Bittersweet2701/Autonomous-Vehicle/README.md

# Graduation_Thesis
# Autonomous-Vehicle
