Bittersweet2701/Autonomous-Vehicle/Hardware/AutonomousVehicle_CurrentMeasurement/AutonomousVehicle_CurrentMeasure.pdf

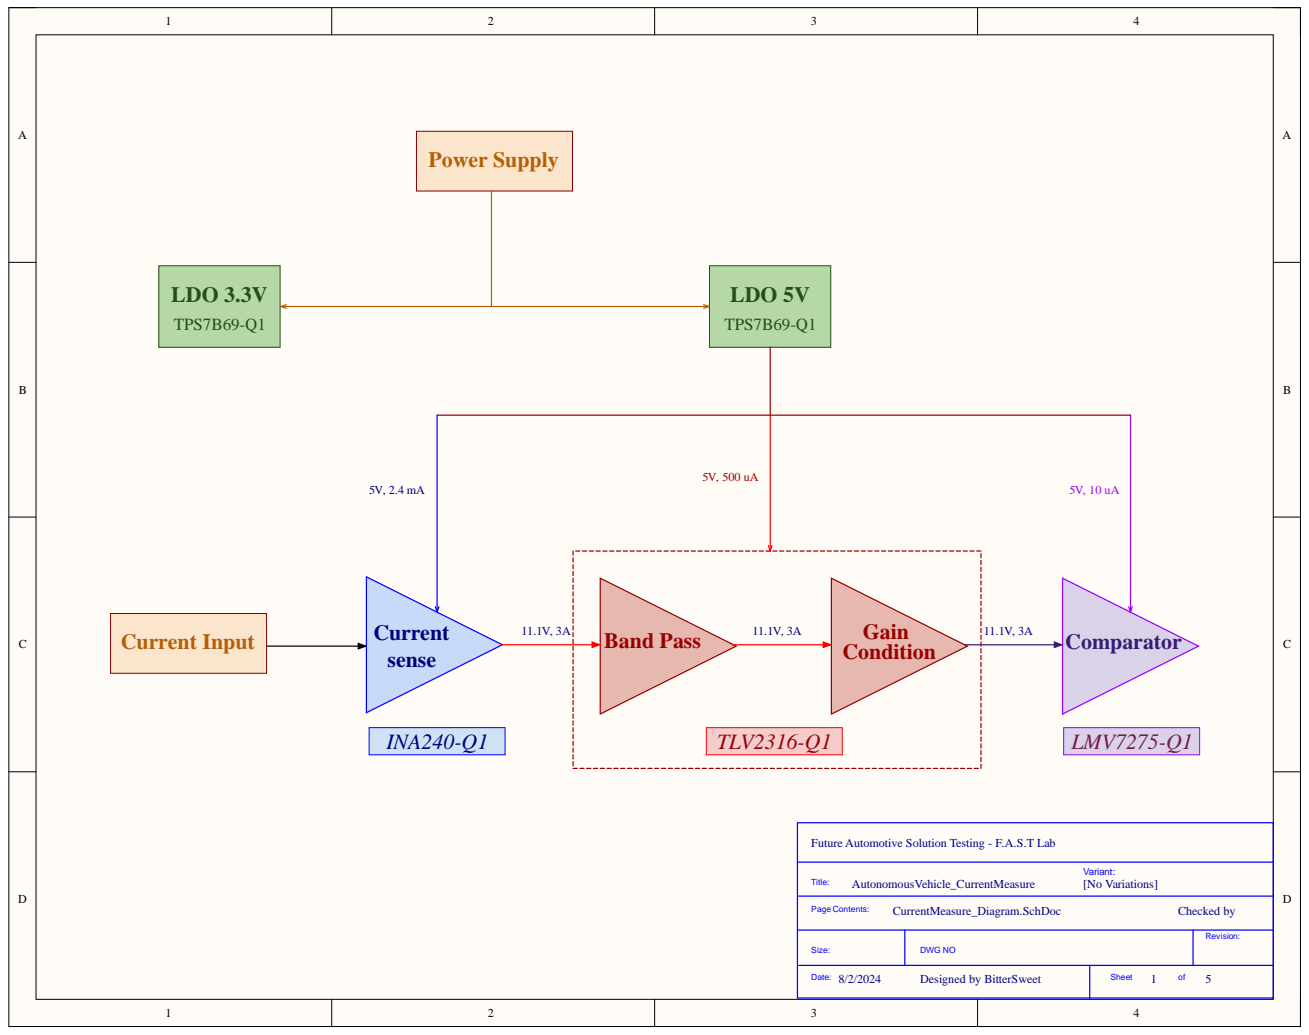
[picture p3: page 1]

Future Automotive Solution Testing - F.A.S.T Lab

Size: | DWG NO | Revision:

Date: 8/2/2024 Designed by BitterSweet | Sheet of

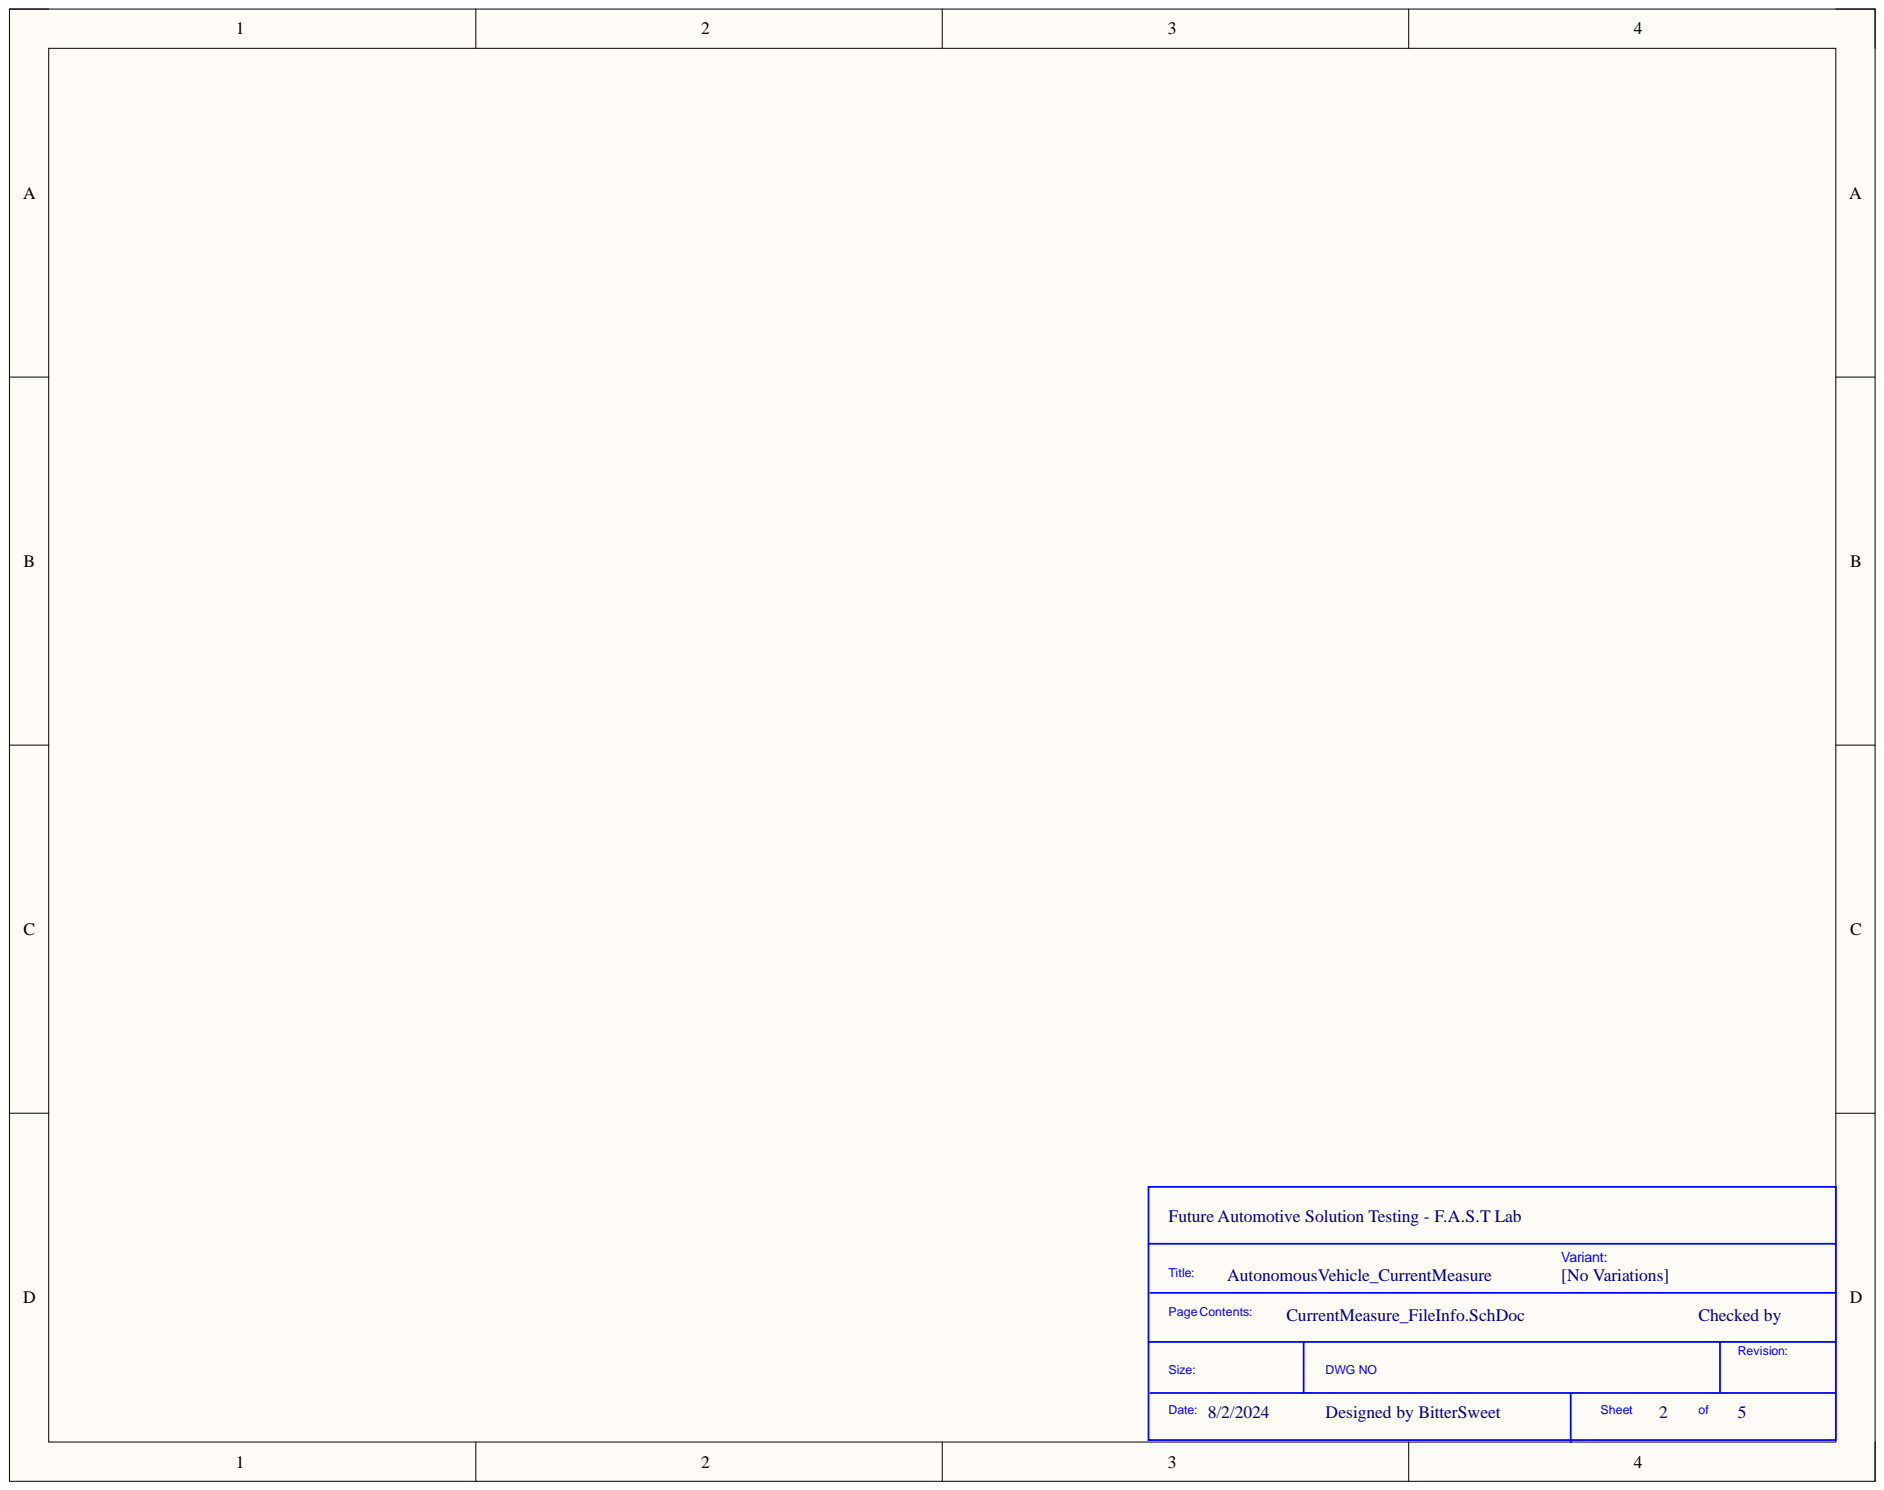
[picture p4: page 2]

Future Automotive Solution Testing - F.A.S.T Lab

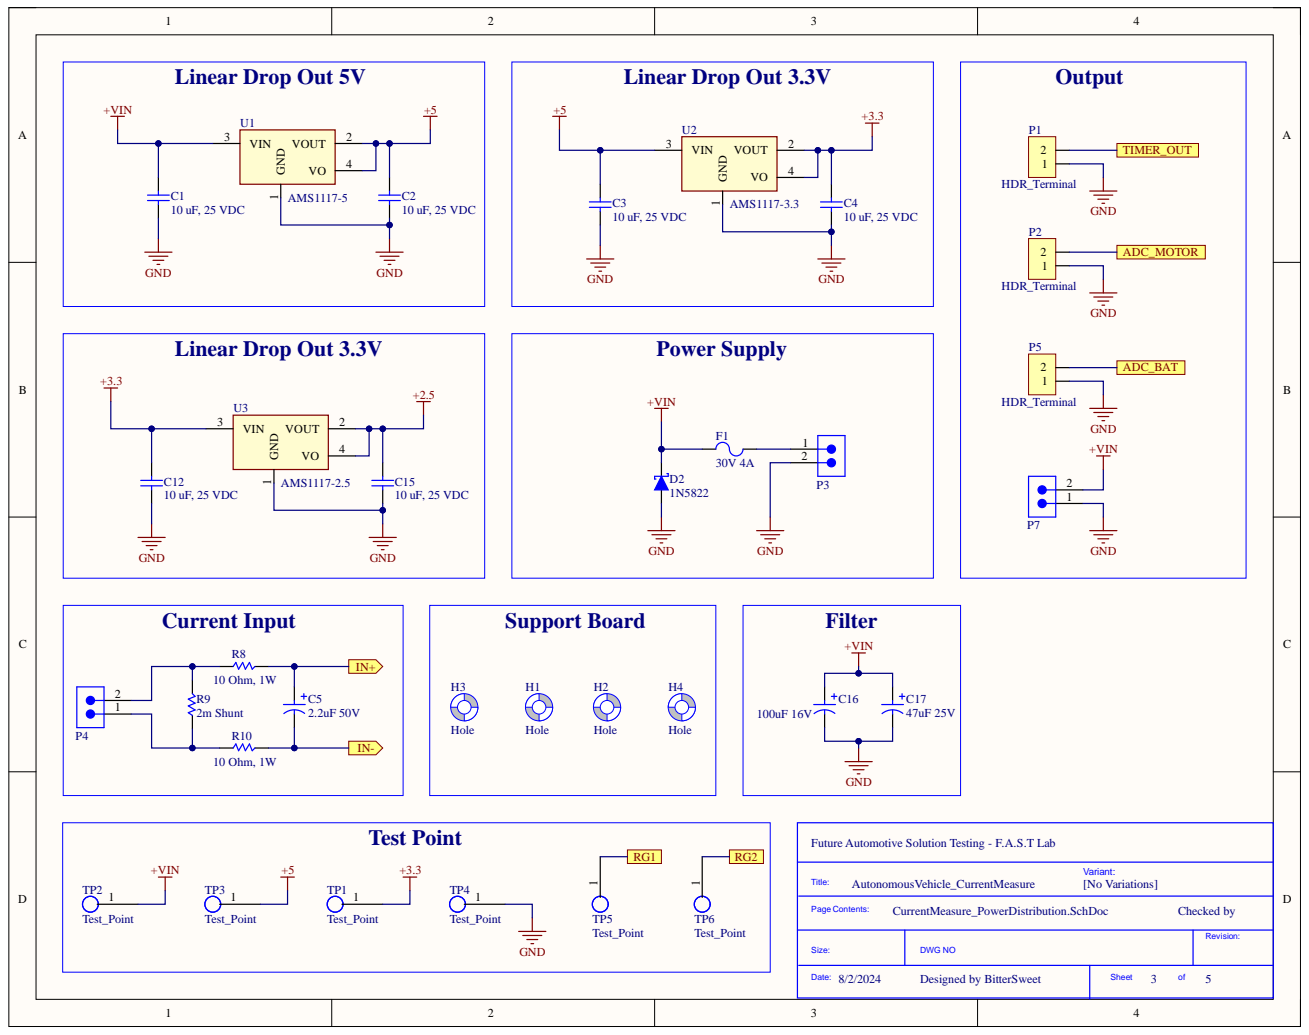
[picture p5: page 3]

Future Automotive Solution Testing - F.A.S.T Lab

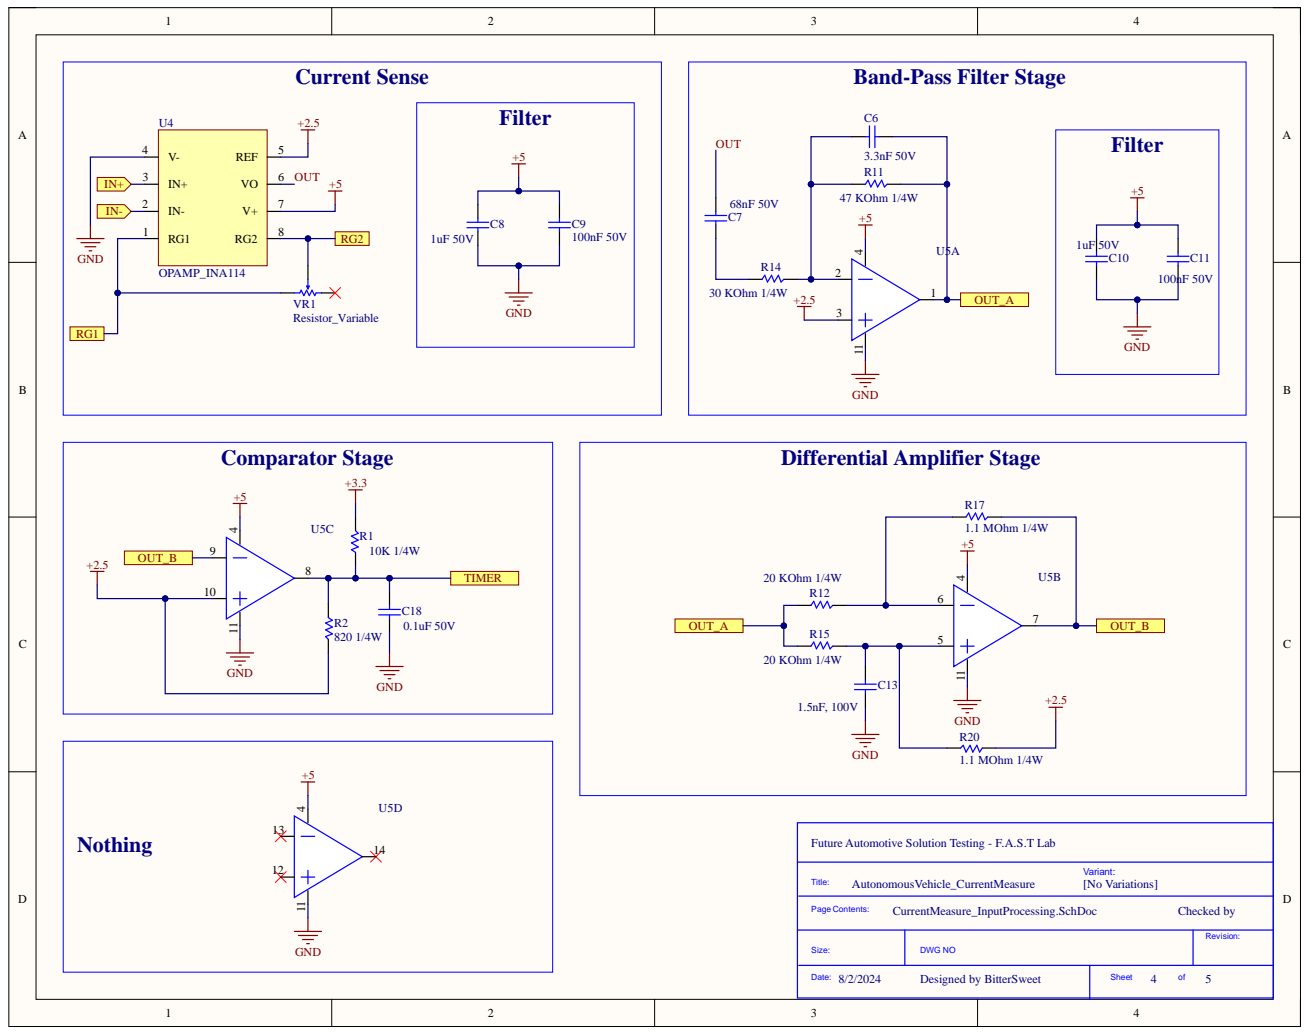
[picture p6: page 4]

Band-Pass Filter Stage

Future Automotive Solution Testing - F.A.S.T Lab

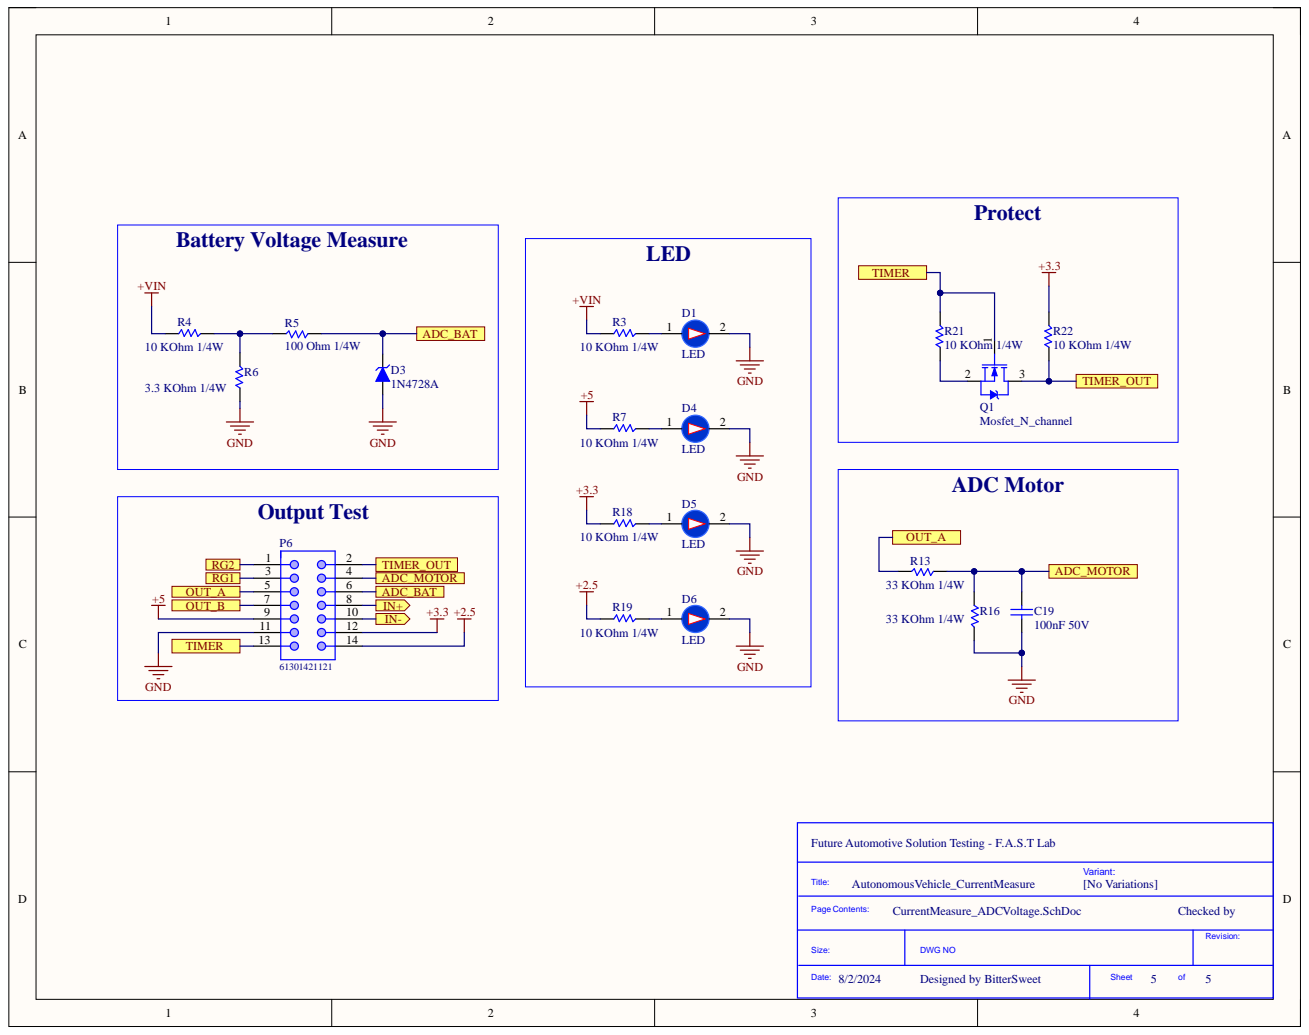
[picture p7: page 5]

Date : 8/2/2024 D e s igned by Bi t t erS w e e t | Sh e e t o f
