Bittersweet2701/Autonomous-Vehicle/Hardware/AutonomousVehicle_MotherBoard/MotherBoard_Diagram.pdf

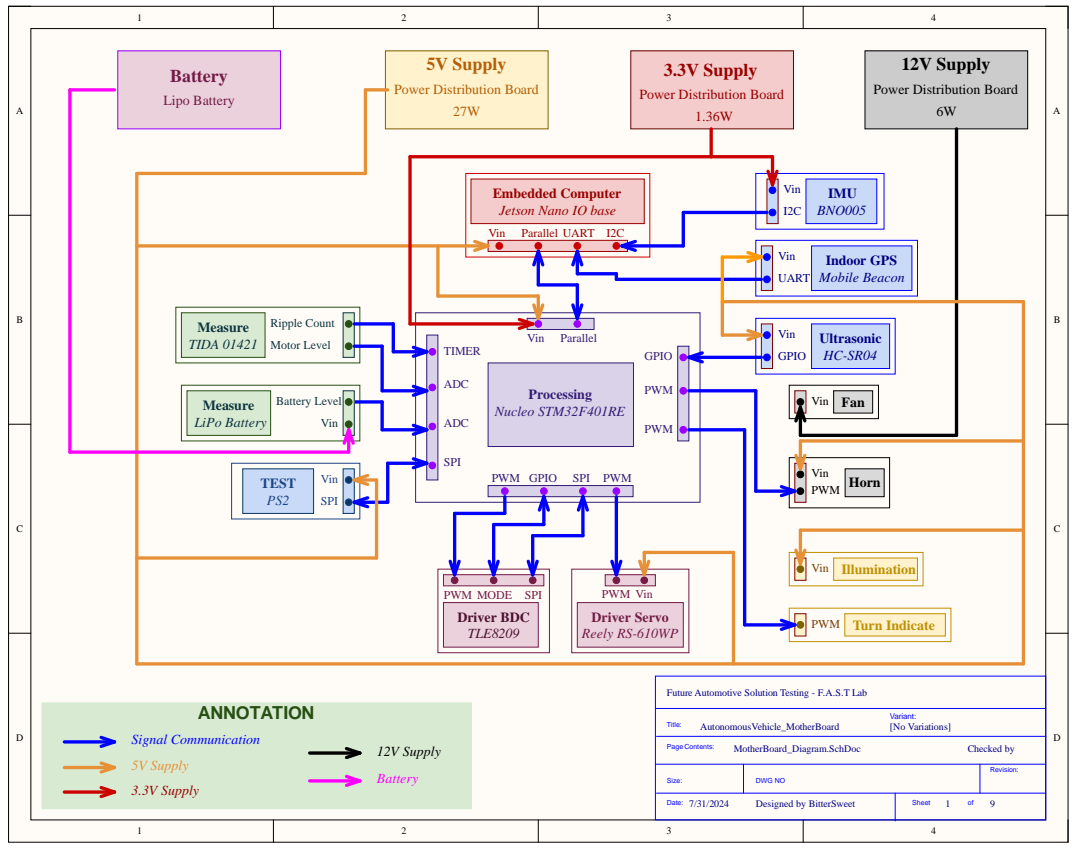
[picture p8: page 1]

Embedded Computer
Jetson Nano IO base

Future Automotive Solution Testing - F.A.S.T Lab

Size: | DWG NO | Revision:

Date: 7/31/2024 Designed by BitterSweet | Sheet 1 of 9
