Bittersweet2701/Autonomous-Vehicle/Hardware/Autonomous_Vehicle_PowerBoard/Autonomous/AutonomousVehicle_PowerBoard.pdf

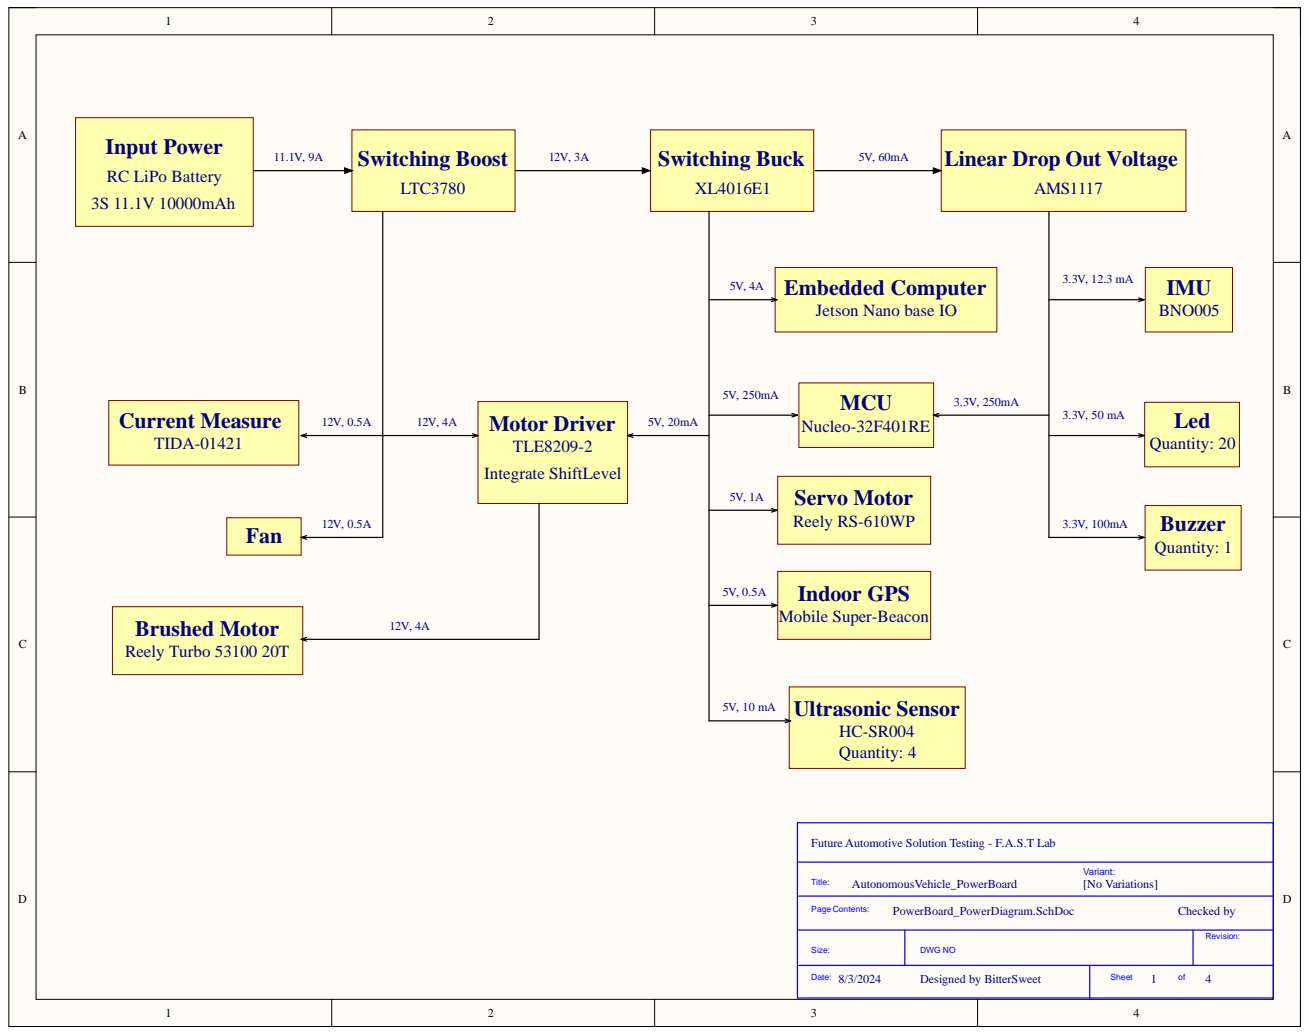
[picture p14: page 1]

Linear Drop Out Voltage

Embedded Computer
Jetson Nano base IO

Future Automotive Solution Testing - F.A.S.T Lab

Size: | DWG NO | Revision:

Date: 8/3/2024 Designed by BitterSweet | Sheet of

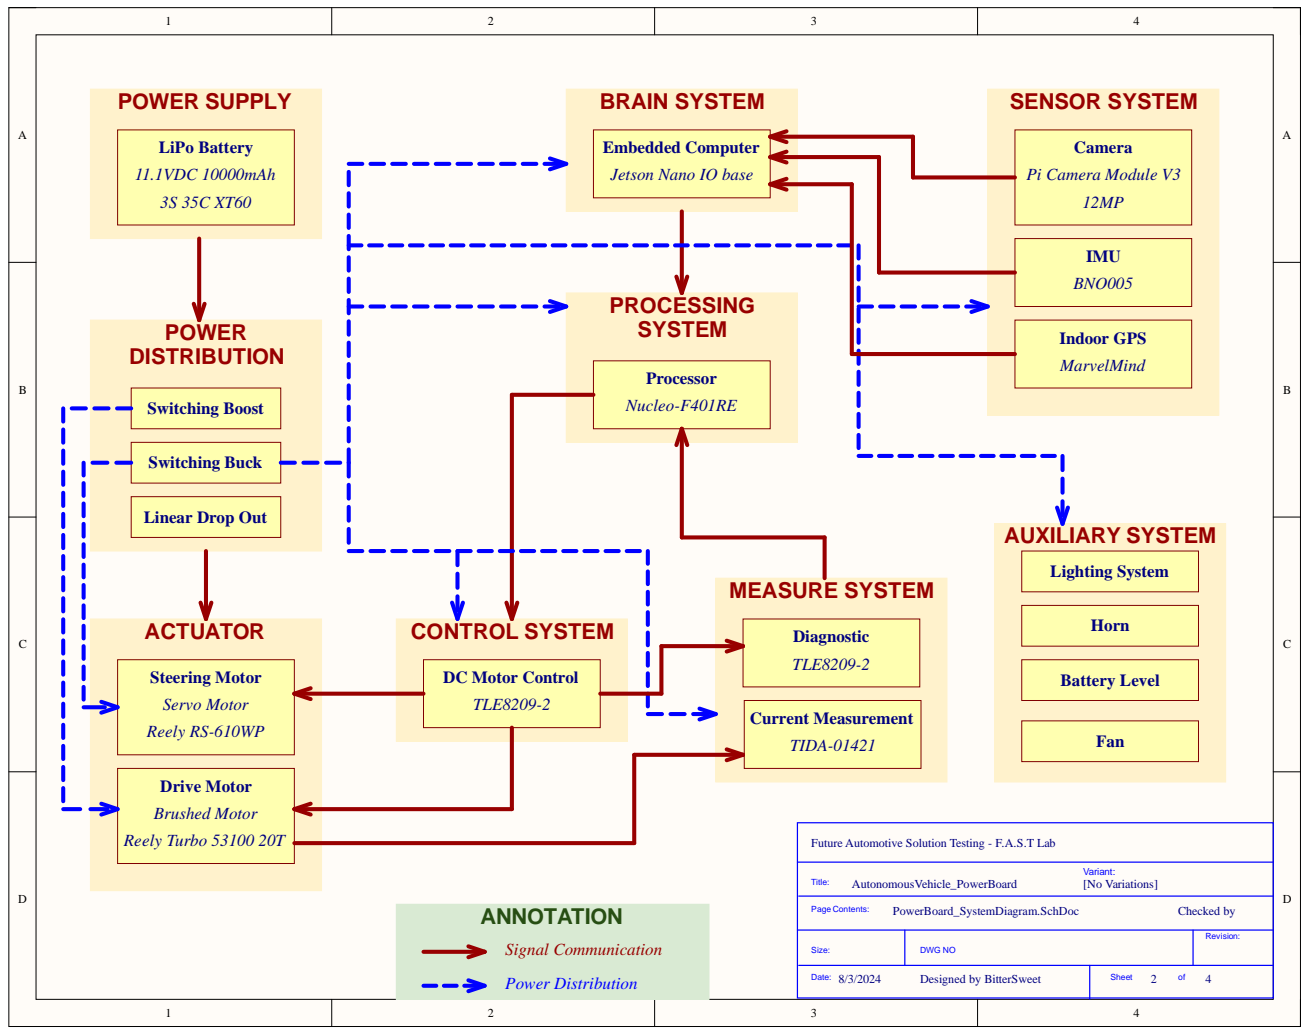
[picture p15: page 2]

Embedded Computer
Jetson Nano IO base

Future Automotive Solution Testing - F.A.S.T Lab

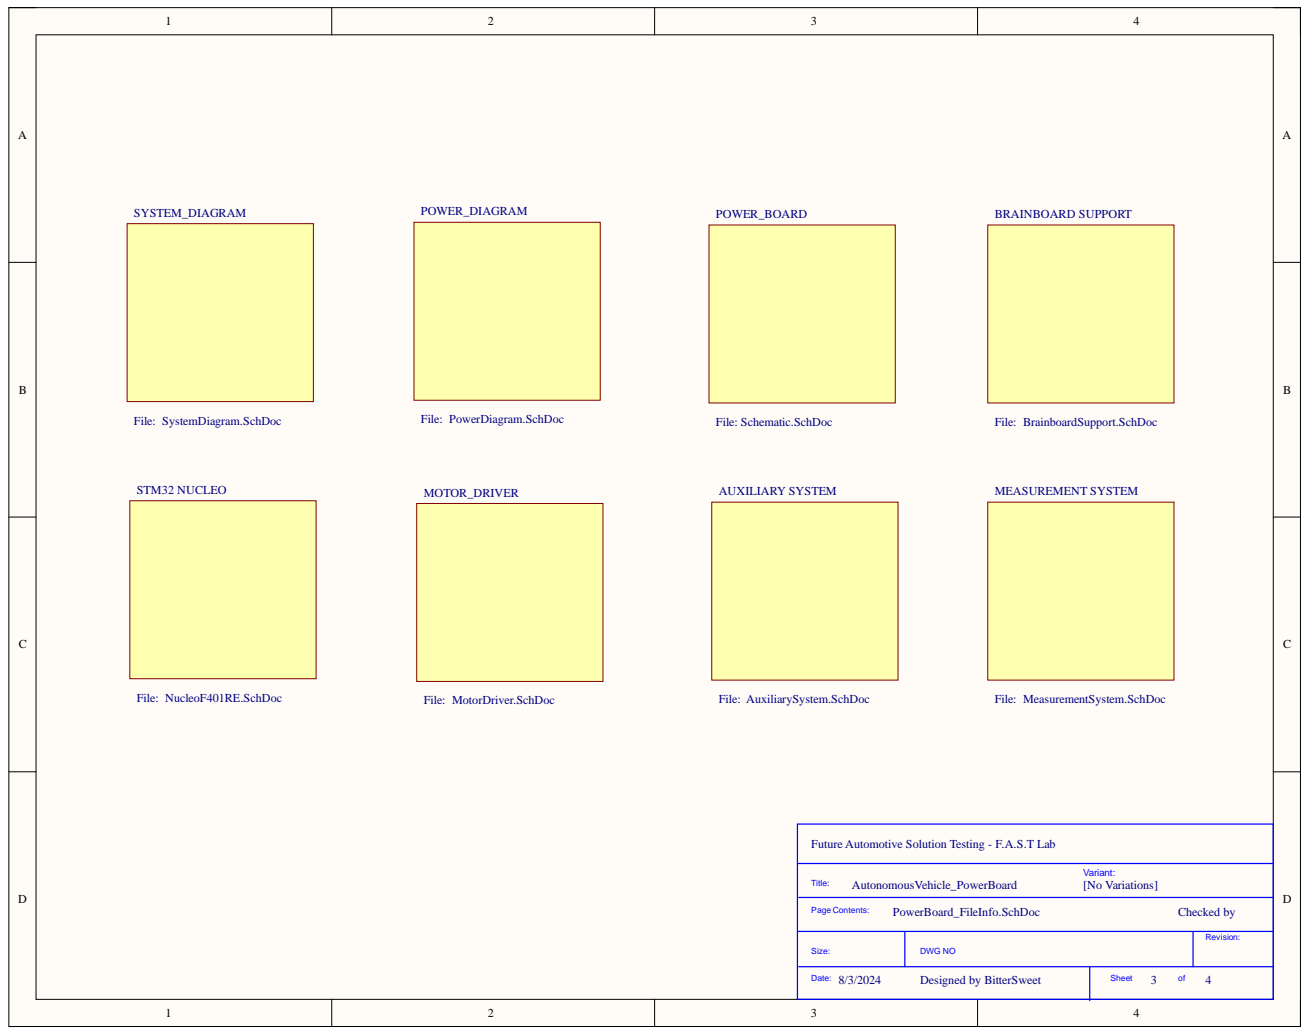
[picture p16: page 3]

Future Automotive Solution Testing - F.A.S.T Lab

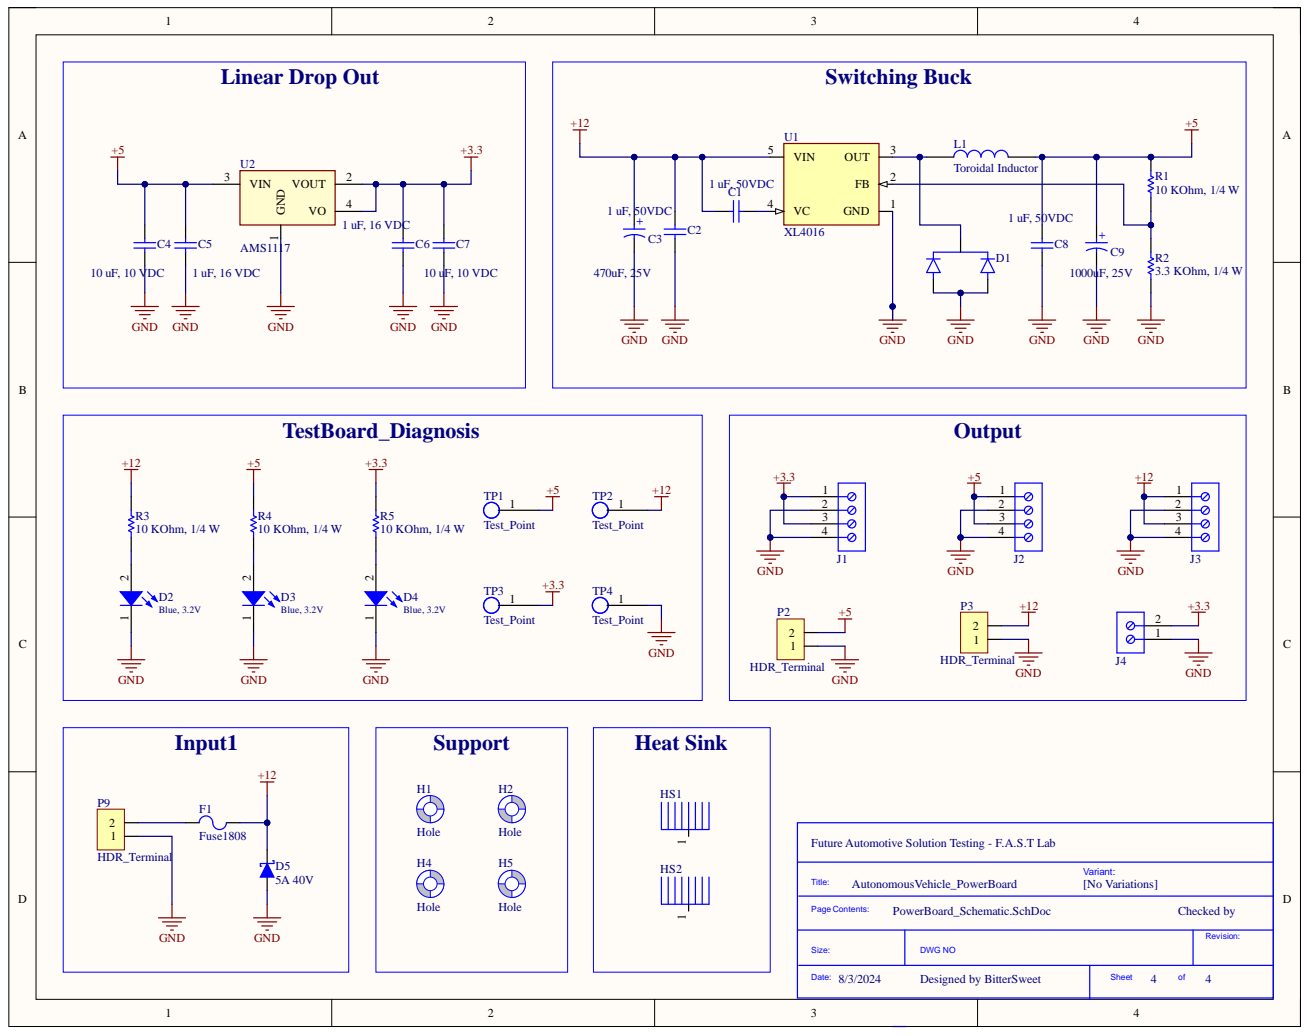
[picture p17: page 4]

Future Automotive Solution Testing - F.A.S.T Lab

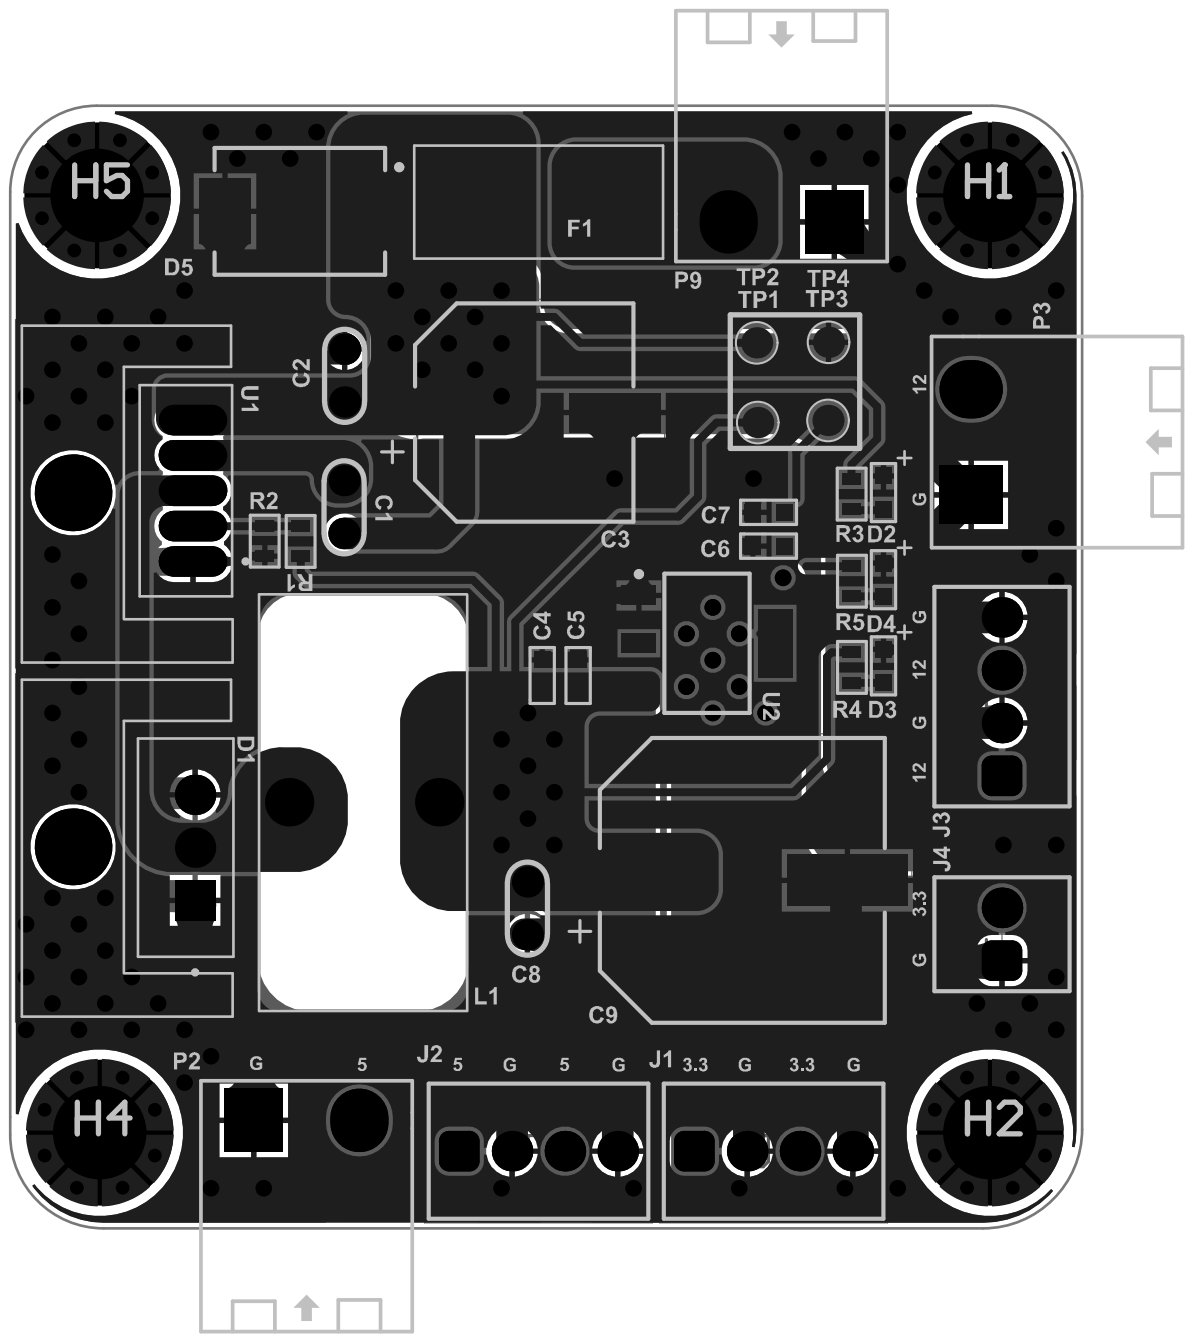
[picture p18: page 5]
