Bittersweet2701/Autonomous-Vehicle/Hardware/AutonomousVehicle_MotherBoard/AutonomousVehicle_MotherBoard.pdf

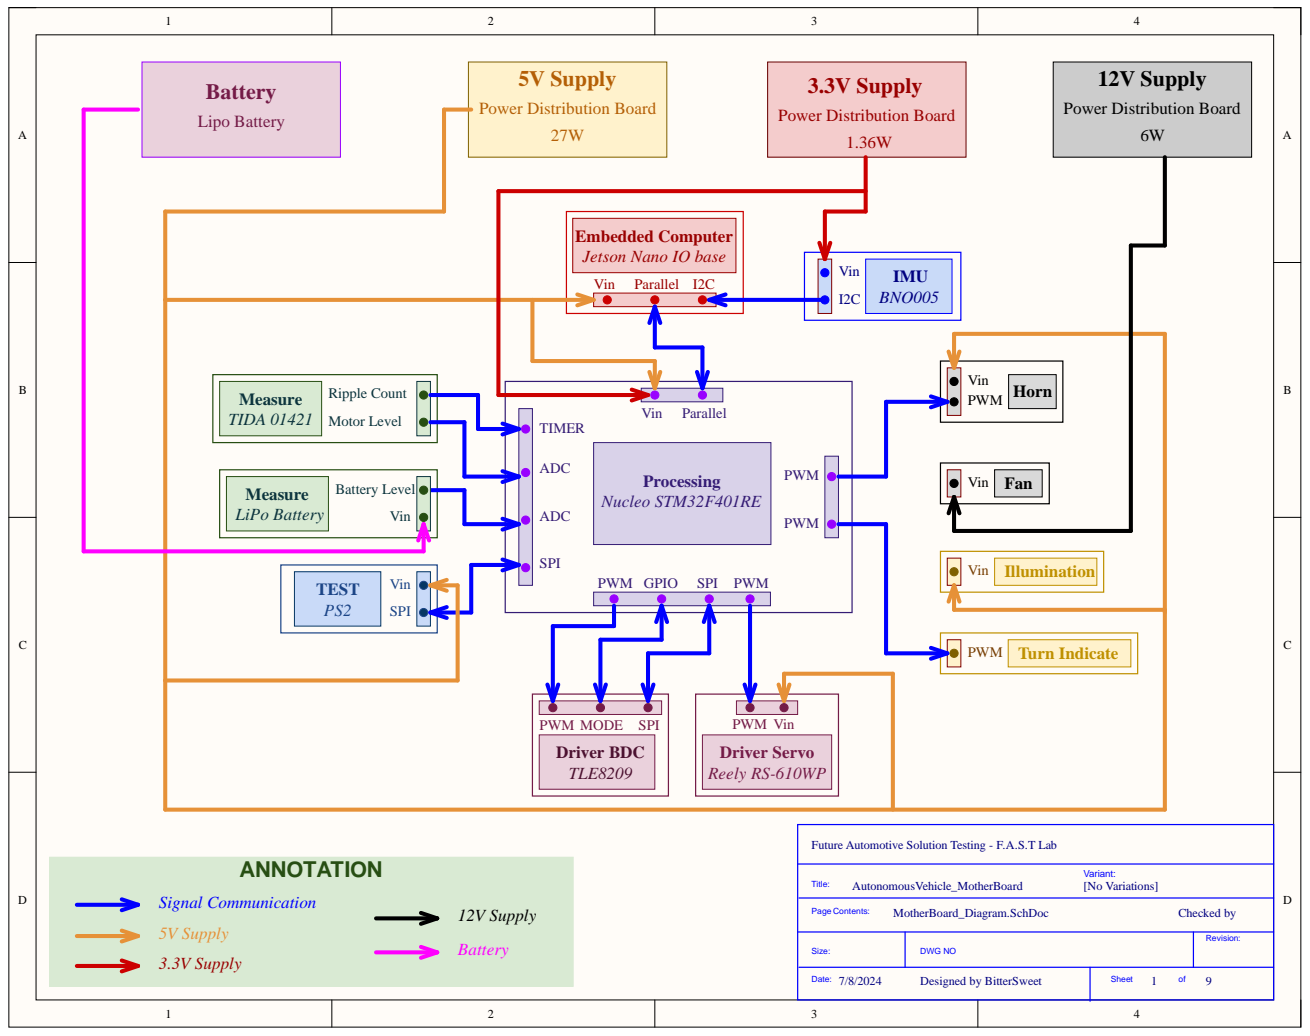
[picture p19: page 1]

Embedded Computer
Jetson Nano IO base

Future Automotive Solution Testing - F.A.S.T Lab

Size: | DWG NO | Revision:

Date: 7/8/2024 Designed by BitterSweet | Sheet of

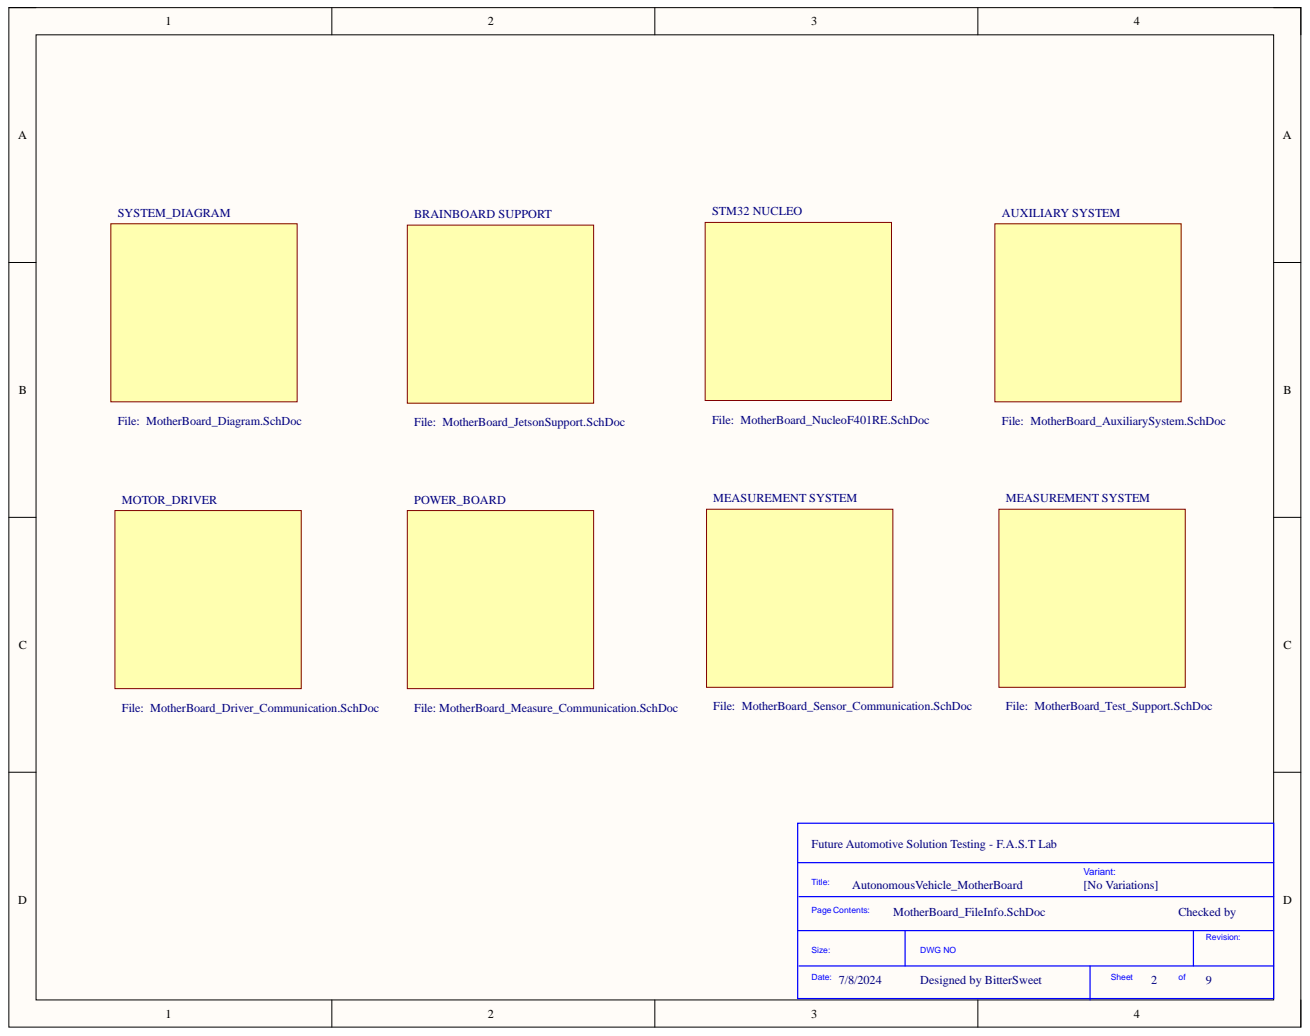
[picture p20: page 2]

Future Automotive Solution Testing - F.A.S.T Lab

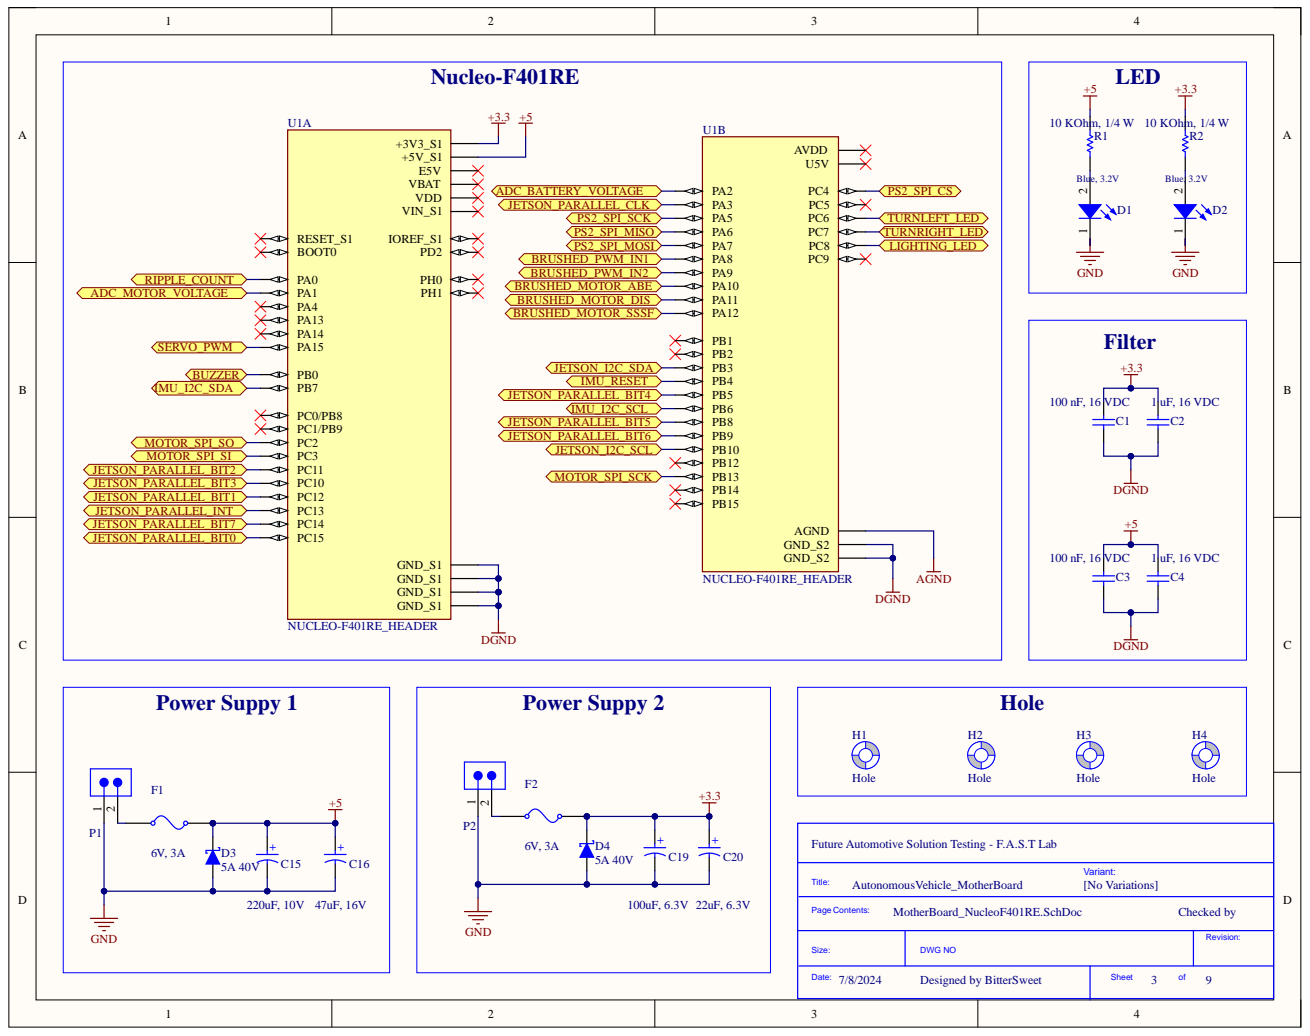
[picture p21: page 3]

Future Automotive Solution Testing - F.A.S.T Lab

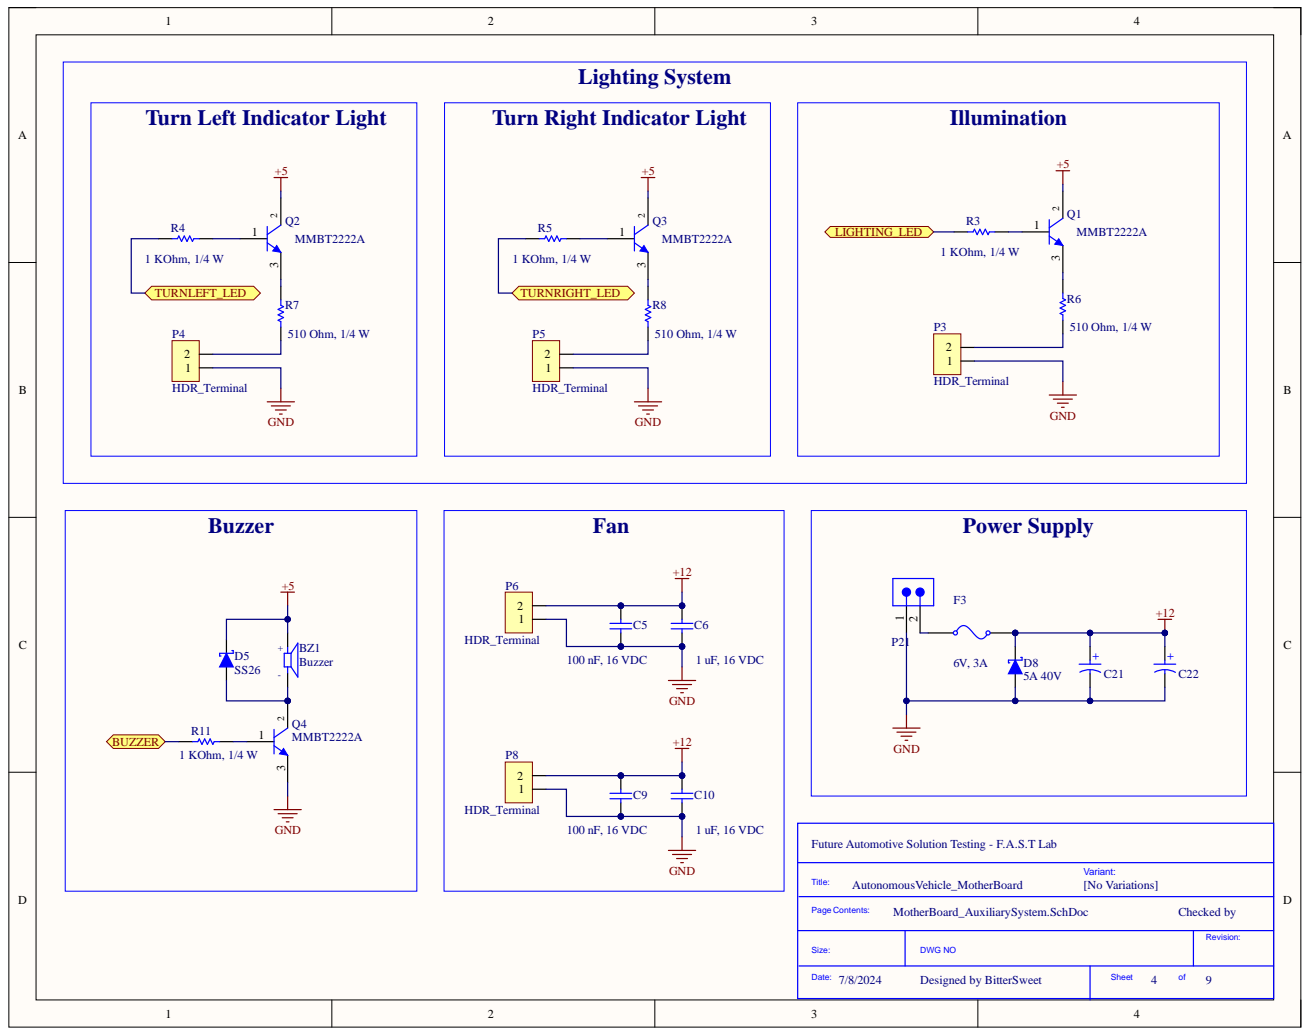
[picture p22: page 4]

Future Automotive Solution Testing - F.A.S.T Lab

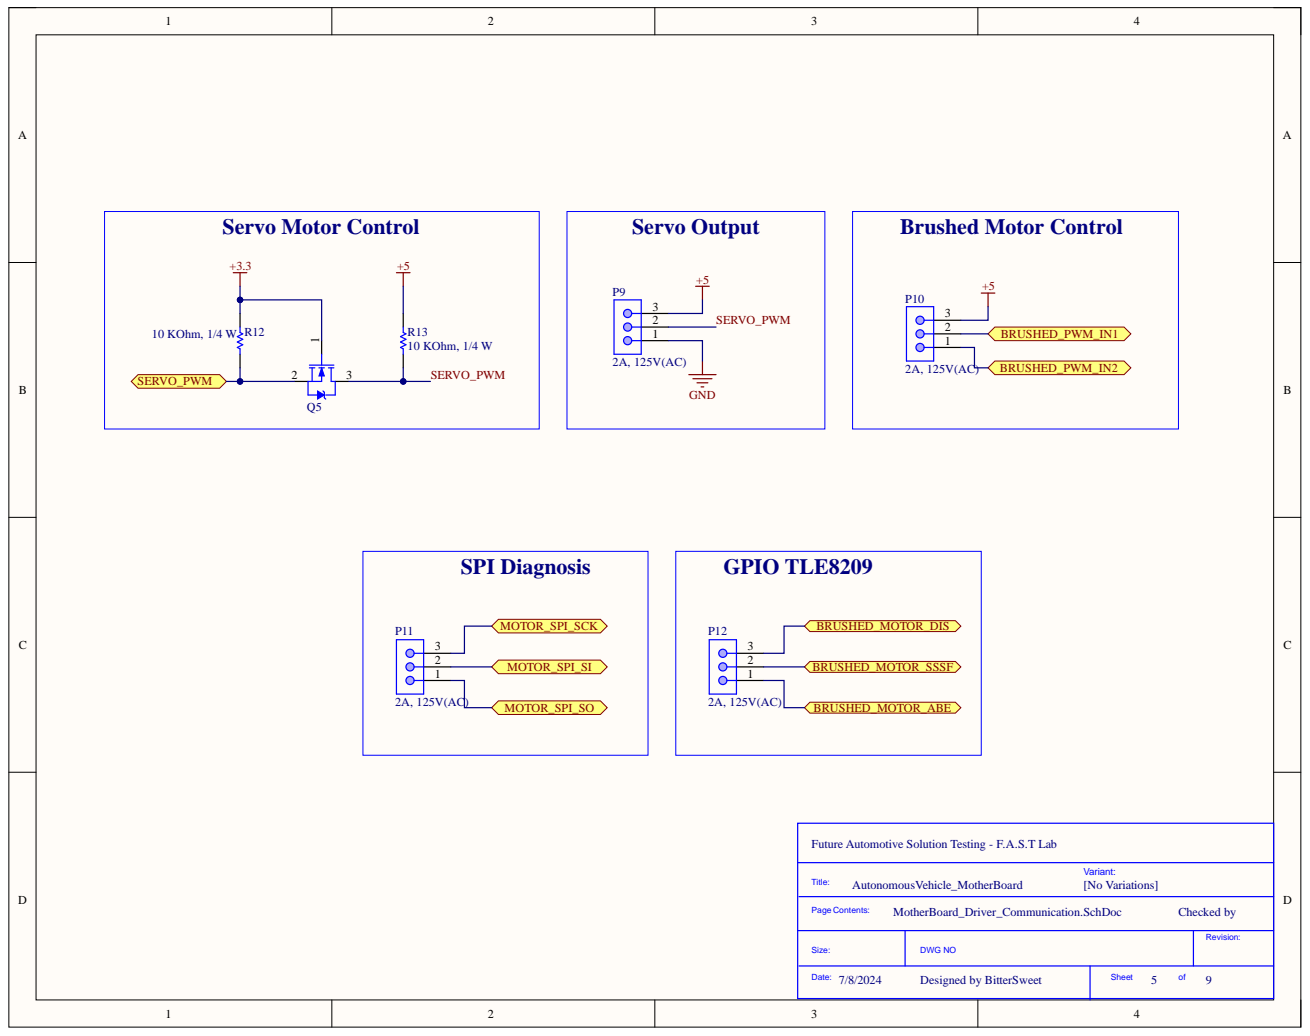
[picture p23: page 5]

Future Automotive Solution Testing - F.A.S.T Lab

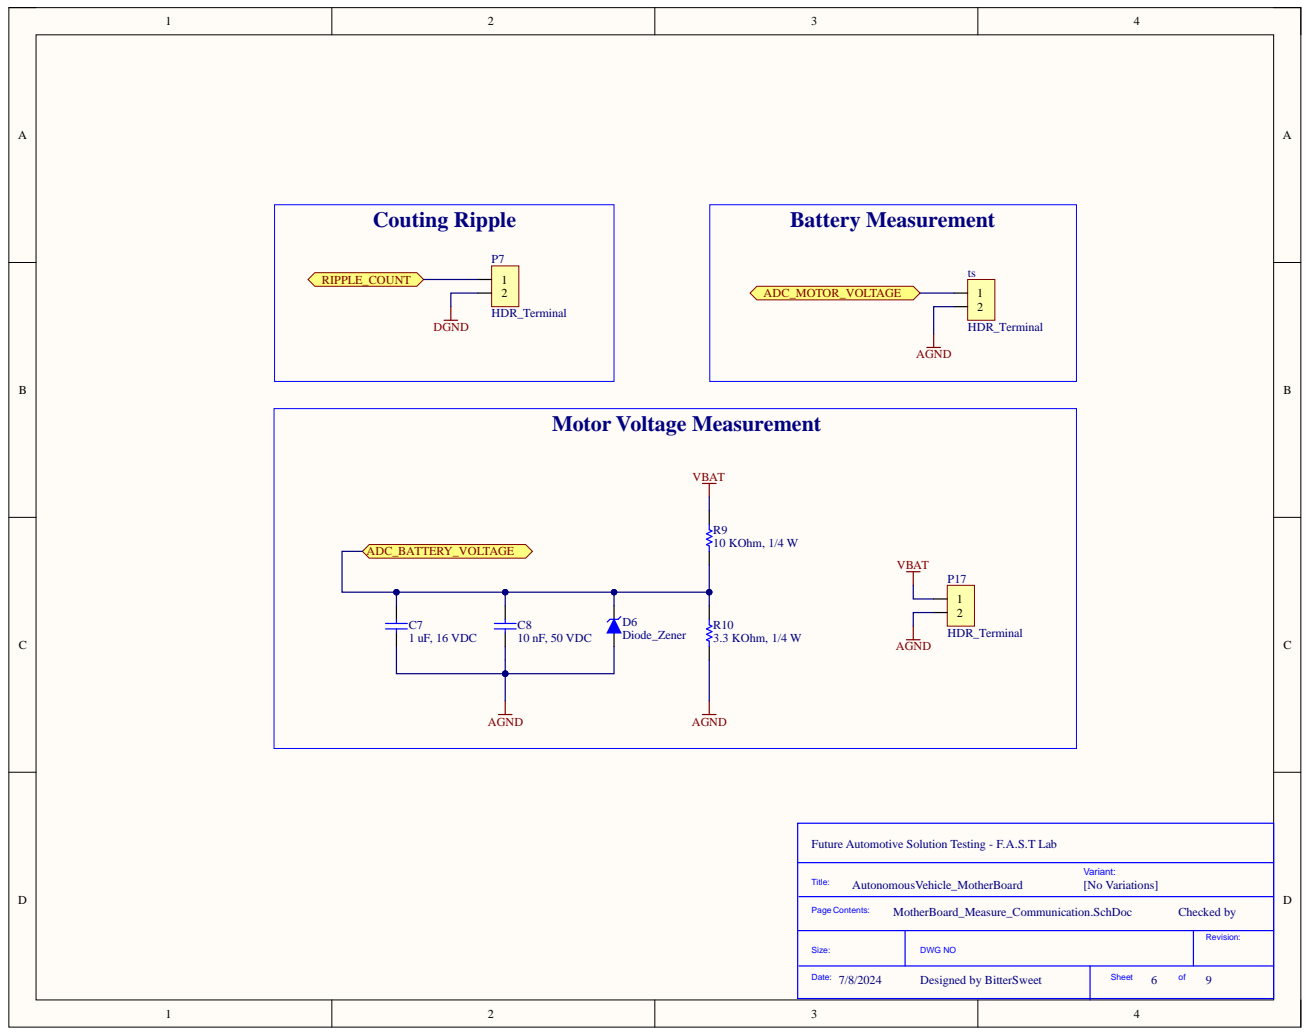
[picture p24: page 6]

Future Automotive Solution Testing - F.A.S.T Lab

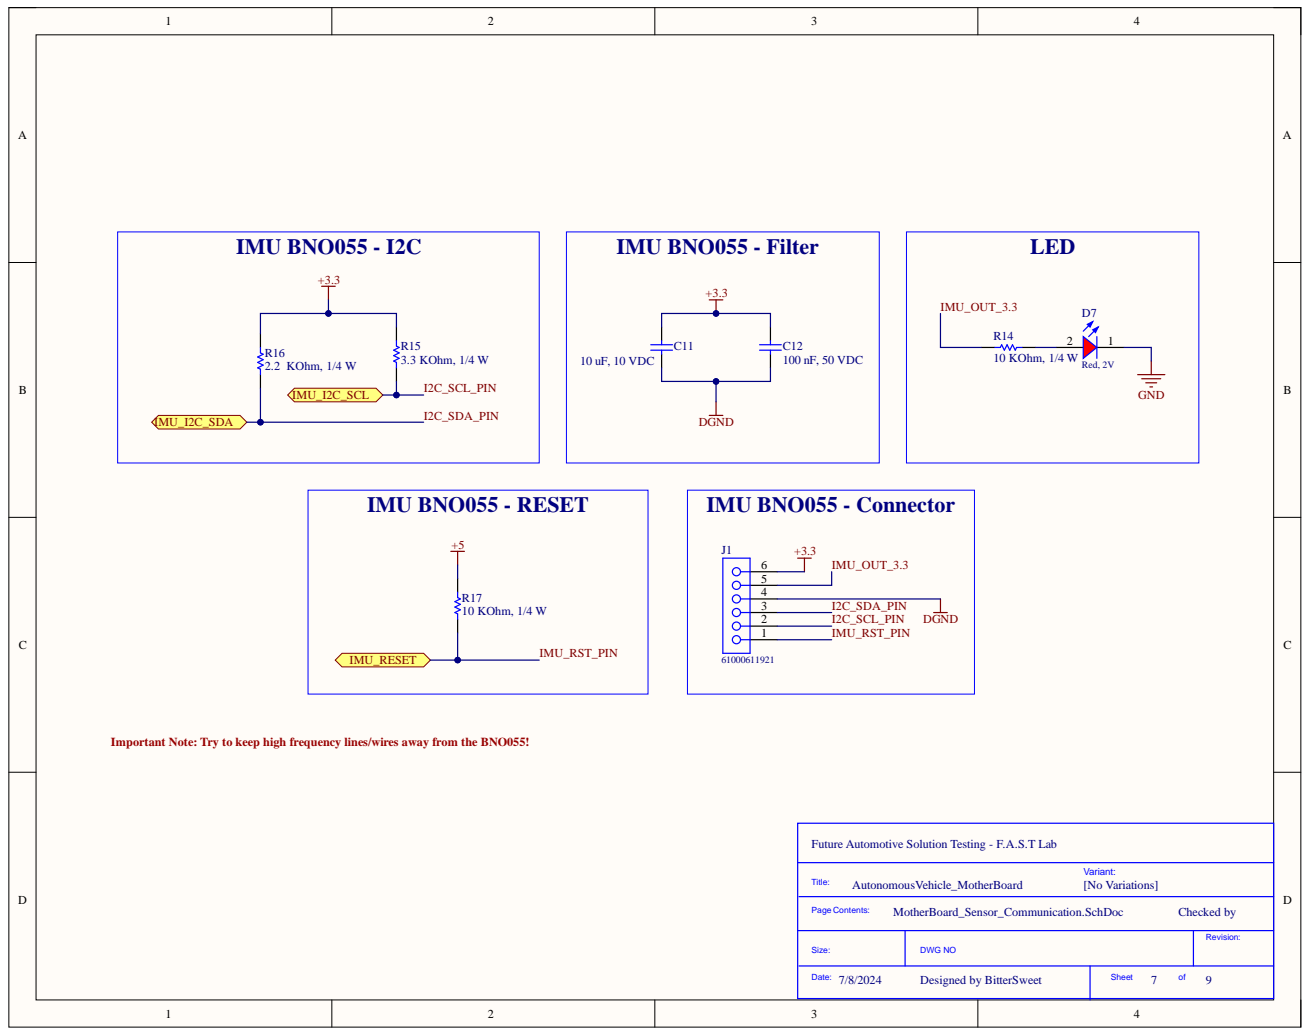
[picture p25: page 7]

Important Note: Try to keep high frequency lines/wires away from the BNO055!

Future Automotive Solution Testing - F.A.S.T Lab

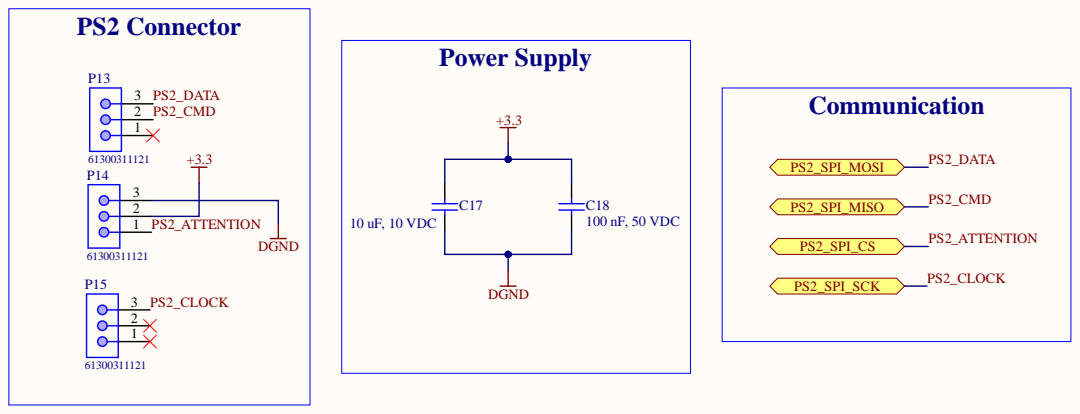
[picture p26: page 8]

Date : 7/8/2024 D e s igned by Bi t t erS w e e t | Sh e e t o f

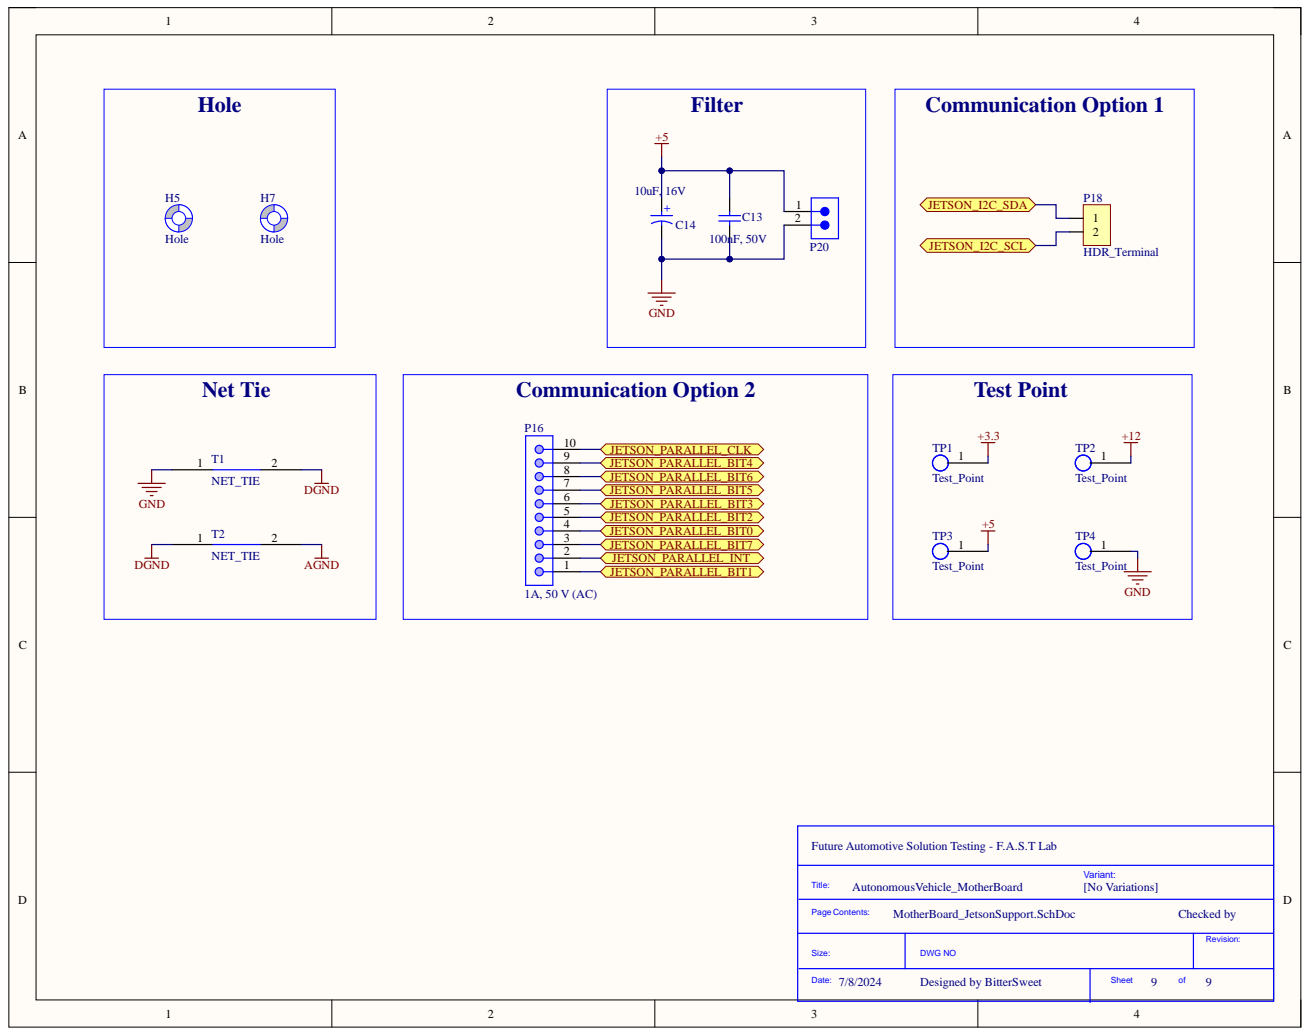
[picture p27: page 9]

Future Automotive Solution Testing - F.A.S.T Lab

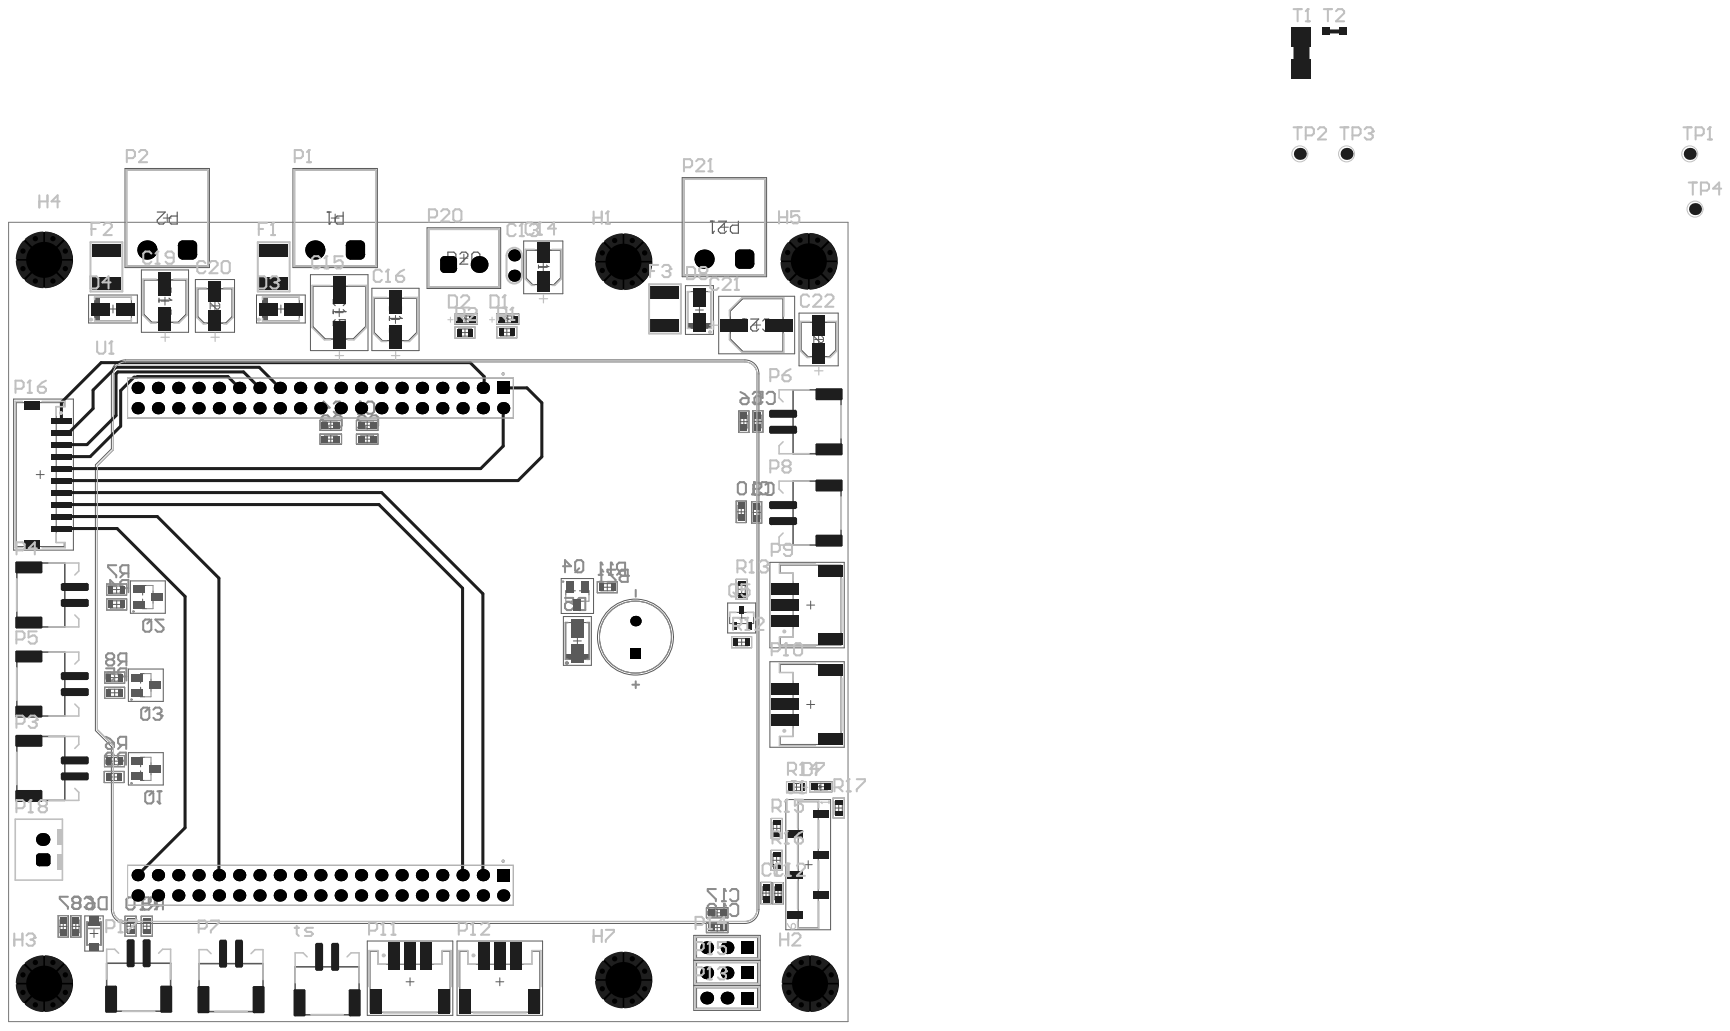
[picture p28: page 10]
