Bittersweet2701/Autonomous-Vehicle/(list of files, drawings)

Other design files:
Hardware/Autonomous_Vehicle_PowerBoard/Autonomous/Autonomous_Vehicle_SystemDiagram.PrjPcb
Hardware/Autonomous_Vehicle_PowerBoard/Autonomous/AutonomousVehicle_PowerBoard.PrjPcb
Hardware/Autonomous_Vehicle_PowerBoard/Autonomous/PowerBoard_FileInfo.SchDoc
Hardware/Autonomous_Vehicle_PowerBoard/Autonomous/PowerBoard_PowerDiagram.SchDoc
Hardware/Autonomous_Vehicle_PowerBoard/Autonomous/PowerBoard_Schematic.SchDoc
Hardware/Autonomous_Vehicle_PowerBoard/Autonomous/PowerBoard_SystemDiagram.SchDoc
Hardware/AutonomousVehicle_CurrentMeasurement/AutonomousVehicle_CurrentMeasure.PcbDoc
Hardware/AutonomousVehicle_CurrentMeasurement/AutonomousVehicle_CurrentMeasure.PrjPcb
Hardware/AutonomousVehicle_CurrentMeasurement/CurrentMeasure_ADCVoltage.SchDoc
Hardware/AutonomousVehicle_CurrentMeasurement/CurrentMeasure_Diagram.SchDoc
Hardware/AutonomousVehicle_CurrentMeasurement/CurrentMeasure_FileInfo.SchDoc
Hardware/AutonomousVehicle_CurrentMeasurement/CurrentMeasure_InputProcessing.SchDoc
Hardware/AutonomousVehicle_CurrentMeasurement/CurrentMeasure_PowerDistribution.SchDoc
Hardware/AutonomousVehicle_CurrentSense/AutonomousVehicle_CurrentSense.PrjPcb
Hardware/AutonomousVehicle_CurrentSense/CurrentSense_ADCVoltage.SchDoc
Hardware/AutonomousVehicle_CurrentSense/CurrentSense_Diagram.SchDoc
Hardware/AutonomousVehicle_CurrentSense/CurrentSense_FileInfo.SchDoc
Hardware/AutonomousVehicle_CurrentSense/CurrentSense_InputProcessing.SchDoc
Hardware/AutonomousVehicle_CurrentSense/CurrentSense_PowerDistribution.SchDoc
Hardware/AutonomousVehicle_MotherBoard/AutonomousVehicle_MotherBoard.PrjPcb
Hardware/AutonomousVehicle_MotherBoard/MotherBoard_AuxiliarySystem.SchDoc
Hardware/AutonomousVehicle_MotherBoard/MotherBoard_Diagram.SchDoc
Hardware/AutonomousVehicle_MotherBoard/MotherBoard_Driver_Communication.SchDoc
Hardware/AutonomousVehicle_MotherBoard/MotherBoard_FileInfo.SchDoc
Hardware/AutonomousVehicle_MotherBoard/MotherBoard_JetsonSupport.SchDoc
Hardware/AutonomousVehicle_MotherBoard/MotherBoard_Measure_Communication.SchDoc
Hardware/AutonomousVehicle_MotherBoard/MotherBoard_NucleoF401RE.SchDoc
Hardware/AutonomousVehicle_MotherBoard/MotherBoard_Sensor_Communication.SchDoc
Hardware/AutonomousVehicle_MotherBoard/MotherBoard_Test_Support.SchDoc
Hardware/AutonomousVehicle_MotorDriver/AutonomousVehicle_MotorDriver.PrjPcb
Hardware/AutonomousVehicle_MotorDriver/MotorDriver_BrushedMotor_Communication.SchDoc
Hardware/AutonomousVehicle_MotorDriver/MotorDriver_BrushedMotor_IO.SchDoc
Hardware/AutonomousVehicle_MotorDriver/MotorDriver_Diagram.SchDoc
Hardware/AutonomousVehicle_MotorDriver/MotorDriver_FileInfo.SchDoc
