Bittersweet2701/Autonomous-Vehicle/Software/AutonomousVehicle_Processor/AutonomousVehicle_Processor.ioc

Mcu.UserName=STM32F401RETx
PA0-WKUP.GPIO_Label=RIPPLE_COUNT
PA0-WKUP.Signal=S_TIM5_CH1
PA1.GPIO_Label=HCSR04_ECHO2
PA1.Signal=S_TIM2_CH2
PA10.GPIO_Label=SERVO_MOTOR
PA10.Signal=S_TIM1_CH3
PA11.GPIO_Label=BRUSHED_MOTOR_DIS
PA11.Signal=GPIO_Output
PA12.GPIO_Label=BRUSHED_MOTOR_SSSF
PA12.Signal=GPIO_Output
PA13.Signal=SYS_JTMS-SWDIO
PA14.Signal=SYS_JTCK-SWCLK
PA15.GPIO_Label=HCSR04_ECHO1
PA15.Signal=S_TIM2_CH1_ETR
PA2.GPIO_Label=HCSR04_ECHO3
PA2.Signal=S_TIM2_CH3
PA3.GPIO_Label=HCSR04_ECHO4
PA3.Signal=S_TIM2_CH4
PA4.GPIO_Label=ADC_BATTERY_VOLTAGE
PA4.Signal=ADCx_IN4
PA5.GPIO_Label=PS2_SPI-SCK
PA5.Signal=SPI1_SCK
PA6.GPIO_Label=PS2_SPI_MISO
PA6.Signal=SPI1_MISO
PA7.GPIO_Label=PS2-SPI_MOSI
PA7.Signal=SPI1_MOSI
PA8.GPIO_Label=BRUSHED_MOTOR_IN1
PA8.Signal=S_TIM1_CH1
PA9.GPIO_Label=BRUSHED_MOTOR_IN2
PA9.Signal=S_TIM1_CH2
PB0.GPIO_Label=BUZZER
PB0.Signal=S_TIM3_CH3
PB1.GPIO_Label=HCSR04_TRIG2
PB1.Signal=GPIO_Output
PB10.GPIO_Label=JETSON_PARALLEL_BIT4
PB10.Signal=GPIO_Output
PB12.GPIO_Label=HCSR04_TRIG4
PB12.Signal=GPXTI12
PB13.GPIO_Label=MOTOR_SPI_SCK
PB13.Signal=SPI2_SCK
PB14.GPIO_Label=JETSON_SPI_INT
PB14.Signal=GPIO_Input
PB15.GPIO_Label=BRUSHED_MOTOR_ABE
PB15.Signal=GPIO_Input
PB2.GPIO_Label=HCSR04_TRIG3
PB2.Signal=GPIO_Output
PB3.GPIO_Label=JETSON_SPI_SCK
PB3.Signal=SPI3_SCK
PB4.GPIO_Label=JETSON_SPI_MISO
PB4.Signal=SPI3_MISO
PB5.GPIO_Label=JETSON_SPI_MOSI
PB5.Signal=SPI3_MOSI
PB6.GPIO_Label=JETSON_IC2_SCL
PB6.Signal=I2C1_SCL
PB7.GPIO_Label=JETSON_I2C_SDA
PB7.Signal=I2C1_SDA
PB8.GPIO_Label=JETSON_PARALLEL_BIT5
PB8.Signal=GPIO_Input
PB9.GPIO_Label=JETSON_PARALLEL_CLK
PB9.Signal=S_TIM4_CH4
PC0.GPIO_Label=ADC_MOTOR_VOLTAGE
PC0.Signal=ADCx_IN10
PC10.GPIO_Label=JETSON_PARALLEL_BIT3
PC10.Signal=GPIO_Input
PC11.GPIO_Label=JETSON_PARALLEL_BIT2
PC11.Signal=GPIO_Input
PC12.GPIO_Label=JETSON_PARALLEL_BIT1
PC12.Signal=GPIO_Input
PC13-ANTI_TAMP.GPIO_Label=JETSON_PARALLEL_INT
PC13-ANTI_TAMP.Signal=GPIO_Input
PC14-OSC32_IN.GPIO_Label=JETSON_PARALLEL_BIT7
PC14-OSC32_IN.Signal=GPIO_Output
PC15-OSC32_OUT.GPIO_Label=JETSON_PARALLEL_BIT0
PC15-OSC32_OUT.Signal=GPIO_Input
PC2.GPIO_Label=MOTOR_SPI_SO
PC2.Signal=SPI2_MISO
PC3.GPIO_Label=MOTOR_SPI_SI
PC3.Signal=SPI2_MOSI
PC4.GPIO_Label=PS2_SPI_CS
PC4.Signal=GPIO_Output
PC5.GPIO_Label=HCSR04_TRIG1
PC5.Signal=GPIO_Output
PC6.GPIO_Label=TURNLEFT_LED
PC6.Signal=S_TIM3_CH1
PC7.GPIO_Label=TURNLRIGHT_LED
PC7.Signal=S_TIM3_CH2
PC8.GPIO_Label=LIGHTING_LED
PC8.Signal=GPIO_Output
PC9.Signal=RCC_MCO_2
PD2.GPIO_Label=JETSON_PARALLEL_BIT6
PD2.Signal=GPIO_Input
