Bittersweet2701/Autonomous-Vehicle/Software/AutonomousVehicle_Processor/Core/Inc/main.h

#define JETSON_PARALLEL_INT_Pin GPIO_PIN_13
#define JETSON_PARALLEL_INT_GPIO_Port GPIOC
#define JETSON_PARALLEL_BIT7_Pin GPIO_PIN_14
#define JETSON_PARALLEL_BIT7_GPIO_Port GPIOC
#define JETSON_PARALLEL_BIT0_Pin GPIO_PIN_15
#define JETSON_PARALLEL_BIT0_GPIO_Port GPIOC
#define ADC_MOTOR_VOLTAGE_Pin GPIO_PIN_0
#define ADC_MOTOR_VOLTAGE_GPIO_Port GPIOC
#define MOTOR_SPI_SO_Pin GPIO_PIN_2
#define MOTOR_SPI_SO_GPIO_Port GPIOC
#define MOTOR_SPI_SI_Pin GPIO_PIN_3
#define MOTOR_SPI_SI_GPIO_Port GPIOC
#define RIPPLE_COUNT_Pin GPIO_PIN_0
#define RIPPLE_COUNT_GPIO_Port GPIOA
#define HCSR04_ECHO2_Pin GPIO_PIN_1
#define HCSR04_ECHO2_GPIO_Port GPIOA
#define HCSR04_ECHO3_Pin GPIO_PIN_2
#define HCSR04_ECHO3_GPIO_Port GPIOA
#define HCSR04_ECHO4_Pin GPIO_PIN_3
#define HCSR04_ECHO4_GPIO_Port GPIOA
#define ADC_BATTERY_VOLTAGE_Pin GPIO_PIN_4
#define ADC_BATTERY_VOLTAGE_GPIO_Port GPIOA
#define PS2_SPI_SCK_Pin GPIO_PIN_5
#define PS2_SPI_SCK_GPIO_Port GPIOA
#define PS2_SPI_MISO_Pin GPIO_PIN_6
#define PS2_SPI_MISO_GPIO_Port GPIOA
#define PS2_SPI_MOSI_Pin GPIO_PIN_7
#define PS2_SPI_MOSI_GPIO_Port GPIOA
#define PS2_SPI_CS_Pin GPIO_PIN_4
#define PS2_SPI_CS_GPIO_Port GPIOC
#define HCSR04_TRIG1_Pin GPIO_PIN_5
#define HCSR04_TRIG1_GPIO_Port GPIOC
#define BUZZER_Pin GPIO_PIN_0
#define BUZZER_GPIO_Port GPIOB
#define HCSR04_TRIG2_Pin GPIO_PIN_1
#define HCSR04_TRIG2_GPIO_Port GPIOB
#define HCSR04_TRIG3_Pin GPIO_PIN_2
#define HCSR04_TRIG3_GPIO_Port GPIOB
#define JETSON_PARALLEL_BIT4_Pin GPIO_PIN_10
#define JETSON_PARALLEL_BIT4_GPIO_Port GPIOB
#define HCSR04_TRIG4_Pin GPIO_PIN_12
#define HCSR04_TRIG4_GPIO_Port GPIOB
#define MOTOR_SPI_SCK_Pin GPIO_PIN_13
#define MOTOR_SPI_SCK_GPIO_Port GPIOB
#define JETSON_SPI_INT_Pin GPIO_PIN_14
#define JETSON_SPI_INT_GPIO_Port GPIOB
#define BRUSHED_MOTOR_ABE_Pin GPIO_PIN_15
#define BRUSHED_MOTOR_ABE_GPIO_Port GPIOB
#define TURNLEFT_LED_Pin GPIO_PIN_6
#define TURNLEFT_LED_GPIO_Port GPIOC
#define TURNLRIGHT_LED_Pin GPIO_PIN_7
#define TURNLRIGHT_LED_GPIO_Port GPIOC
#define LIGHTING_LED_Pin GPIO_PIN_8
#define LIGHTING_LED_GPIO_Port GPIOC
#define BRUSHED_MOTOR_IN1_Pin GPIO_PIN_8
#define BRUSHED_MOTOR_IN1_GPIO_Port GPIOA
#define BRUSHED_MOTOR_IN2_Pin GPIO_PIN_9
#define BRUSHED_MOTOR_IN2_GPIO_Port GPIOA
#define SERVO_MOTOR_Pin GPIO_PIN_10
#define SERVO_MOTOR_GPIO_Port GPIOA
#define BRUSHED_MOTOR_DIS_Pin GPIO_PIN_11
#define BRUSHED_MOTOR_DIS_GPIO_Port GPIOA
#define BRUSHED_MOTOR_SSSF_Pin GPIO_PIN_12
#define BRUSHED_MOTOR_SSSF_GPIO_Port GPIOA
#define HCSR04_ECHO1_Pin GPIO_PIN_15
#define HCSR04_ECHO1_GPIO_Port GPIOA
#define JETSON_PARALLEL_BIT3_Pin GPIO_PIN_10
#define JETSON_PARALLEL_BIT3_GPIO_Port GPIOC
#define JETSON_PARALLEL_BIT2_Pin GPIO_PIN_11
#define JETSON_PARALLEL_BIT2_GPIO_Port GPIOC
#define JETSON_PARALLEL_BIT1_Pin GPIO_PIN_12
#define JETSON_PARALLEL_BIT1_GPIO_Port GPIOC
#define JETSON_PARALLEL_BIT6_Pin GPIO_PIN_2
#define JETSON_PARALLEL_BIT6_GPIO_Port GPIOD
#define JETSON_SPI_SCK_Pin GPIO_PIN_3
#define JETSON_SPI_SCK_GPIO_Port GPIOB
#define JETSON_SPI_MISO_Pin GPIO_PIN_4
#define JETSON_SPI_MISO_GPIO_Port GPIOB
#define JETSON_SPI_MOSI_Pin GPIO_PIN_5
#define JETSON_SPI_MOSI_GPIO_Port GPIOB
#define JETSON_IC2_SCL_Pin GPIO_PIN_6
#define JETSON_IC2_SCL_GPIO_Port GPIOB
#define JETSON_I2C_SDA_Pin GPIO_PIN_7
#define JETSON_I2C_SDA_GPIO_Port GPIOB
#define JETSON_PARALLEL_BIT5_Pin GPIO_PIN_8
#define JETSON_PARALLEL_BIT5_GPIO_Port GPIOB
#define JETSON_PARALLEL_CLK_Pin GPIO_PIN_9
#define JETSON_PARALLEL_CLK_GPIO_Port GPIOB
