Bittersweet2701/Autonomous-Vehicle/(commit log)

2024-07-17 Remove Hardware folder from repository
    [AutonomousVehicle_CurrentMeasure.PrjPcb, AutonomousVehicle_MotherBoard.PrjPcb, AutonomousVehicle_MotorDriver.PrjPcb, AutonomousVehicle_PowerBoard.PcbDoc, AutonomousVehicle_PowerBoard.PrjPcb, Autonomous_Vehicle_SystemDiagram.PrjPcb, CurrentMeasure_Diagram.SchDoc, CurrentMeasure_FileInfo.SchDoc]
2024-07-17 Update Hardware
    [AutonomousVehicle_CurrentMeasure.PrjPcb, AutonomousVehicle_MotherBoard.PrjPcb, AutonomousVehicle_MotorDriver.PrjPcb, AutonomousVehicle_PowerBoard.PrjPcb, Autonomous_Vehicle_SystemDiagram.PrjPcb, CurrentMeasure_Diagram.SchDoc, CurrentMeasure_FileInfo.SchDoc, CurrentMeasure_InputProcessing.SchDoc]
